yazanus94-dot/Open-Source-Engineering-Simulation-Portfolio/03-cadquery-parametric-flange/README.md

# CadQuery Parametric Flange

**Domain:** CAD / Parametric Design  
**Author:** [Yazan Aljabari](https://www.linkedin.com/in/yazan-aljabari-878202139/)  
**Part of:** [Open-Source Engineering Simulation Portfolio](../README.md)

## Overview
Parametric solid modeling in CadQuery (outer/inner diameters, thickness, PCD, hole count/size) with export utilities and unit tests.

## Problem statement
Generate a parametric bolt-circle pipe flange and export STEP/STL artifacts programmatically.

## Objectives
- Provide a clear, reproducible project setup for the stated engineering/scientific workflow.
- Capture core modeling/simulation/design assumptions in versioned source files.
- Document expected inputs, execution steps, and interpretation boundaries without fabricating results.

## Features
- Source/configuration artifacts included and tracked in this directory: see **Project structure**.
- Domain-appropriate workflow using: CadQuery, Python, pytest.
- Documentation of prerequisites, usage, methodology, and limitations for transparent reuse.

## Technologies
Python, CadQuery, OCP, pytest, STEP/STL

## Project structure
```text
03-cadquery-parametric-flange/
  README.md
  flange.py
  requirements.txt
  tests/test_flange.py
```

## Installation
### Prerequisites
- Install the required external toolchain(s) for this project (e.g., CadQuery, Python, pytest) using official/vendor instructions for your OS.
- A POSIX-like shell is helpful for `.sh` scripts; on Windows, use WSL/Git Bash/MSYS2 or adapt commands as needed.
- For Python-based utilities/tests (if present), Python 3.10+ and `pip` are recommended.

### Setup
1. Open this project directory.
2. Install tool-specific dependencies listed in local files (e.g., `requirements.txt`, `Makefile`, input decks).
3. Ensure required solvers/tools are on `PATH`.

## Usage
Refer to the included scripts/configuration files in this directory and the original project notes below.
- If Python tests are included, run them with `pytest` in an environment where project dependencies are available.

Typical artifacts produced by simulation/design tools (meshes, logs, field outputs, plots, binaries) are generated by running the workflow and may be excluded or regenerated as needed.

## Methodology
- **Inputs/configuration:** Defined by the included source, input, mesh, or netlist files in this folder.
- **Execution:** Run the provided script/command flow with the appropriate solver or EDA/CAD tool.
- **Outputs/analysis:** Post-process generated results with included scripts/tools (e.g., ParaView, plotting utilities, testbenches/check scripts) when applicable.
- **Validation approach:** Compare against analytical/benchmark expectations or built-in checks described in project files where provided; do not claim results that were not produced.

## Results
No fabricated numerical/experimental results are included. This repository contains the **source inputs, scripts, and configuration** required to run the workflow. When executed in a properly configured environment with the required external tools, results (fields, plots, logs, meshes, waveforms, or derived metrics) are produced by those tools. Any example outputs documented in the original project notes are tool-generated and should be reproduced by the user.

## Testing
- If a `tests/` directory or test scripts are present, run them in a compatible environment (some require domain packages such as CadQuery/pymatgen or external tools).
- Where automated tests are not feasible without external solvers, validation is performed by correct configuration, script structure, and reproducible run instructions.

## Limitations
- Requires external domain-specific software that is not bundled in this repository.
- Simplified/educational setups may not capture all real-world physics, manufacturing constraints, or production verification requirements.
- Results depend on tool versions, meshes/time steps/tolerances, and environment configuration.
- No guaranteed solver outputs are committed unless explicitly included as generated artifacts.

## Future improvements
- Add containerized/tool-version-pinned environments for deterministic runs.
- Include verified reference outputs (logs/plots/metrics) generated from documented tool versions.
- Expand automated checks and CI coverage where lightweight validation is possible.
- Add parameter sweeps, convergence studies, or verification/validation benchmarks.

## References
- Tool/vendor documentation for listed technologies (OpenFOAM, Elmer, SU2, CalculiX, Gmsh, FEniCSx, Quantum ESPRESSO, LAMMPS, ngspice, Xyce, Yosys, Verilator, KiCad, CadQuery, OpenSCAD, PyBaMM, ASE, pymatgen) as applicable.
- Project source files included in this directory.

## License
This project is licensed under the **MIT License** (see repository root [`LICENSE`](../LICENSE)).

## Original project notes
# CadQuery - Parametric Pipe Flange with Unit Tests

Code-CAD flange (bolt circle, hub, bore) driven by parameters; exports STEP/STL and computes mass.
A pytest suite verifies the solid volume against the analytical formula - CAD treated as testable software.

```bash
pip install -r requirements.txt
python flange.py --od 160 --bolts 8
pytest -q
```
View `flange.step` in FreeCAD / `cq-editor`; slice `flange.stl` for 3D printing.

## Skills demonstrated
Parametric design, selectors, boolean ops, STEP/STL export, test-driven CAD.
