yazanus94-dot/Open-Source-Engineering-Simulation-Portfolio/11-xyce-bridge-rectifier/README.md

# Xyce Bridge Rectifier

**Domain:** Circuit Simulation / Power Electronics  
**Author:** [Yazan Aljabari](https://www.linkedin.com/in/yazan-aljabari-878202139/)  
**Part of:** [Open-Source Engineering Simulation Portfolio](../README.md)

## Overview
Xyce transient simulation of a full-wave bridge with scripted execution and Python post-processing/analysis.

## Problem statement
Simulate a diode bridge rectifier with RC smoothing and quantify ripple/output characteristics.

## Objectives
- Provide a clear, reproducible project setup for the stated engineering/scientific workflow.
- Capture core modeling/simulation/design assumptions in versioned source files.
- Document expected inputs, execution steps, and interpretation boundaries without fabricating results.

## Features
- Source/configuration artifacts included and tracked in this directory: see **Project structure**.
- Domain-appropriate workflow using: Xyce, Python.
- Documentation of prerequisites, usage, methodology, and limitations for transparent reuse.

## Technologies
Xyce, SPICE, Python, Shell

## Project structure
```text
11-xyce-bridge-rectifier/
  README.md
  analyze.py
  bridge.cir
  run.sh
```

## Installation
### Prerequisites
- Install the required external toolchain(s) for this project (e.g., Xyce, Python) using official/vendor instructions for your OS.
- A POSIX-like shell is helpful for `.sh` scripts; on Windows, use WSL/Git Bash/MSYS2 or adapt commands as needed.
- For Python-based utilities/tests (if present), Python 3.10+ and `pip` are recommended.

### Setup
1. Open this project directory.
2. Install tool-specific dependencies listed in local files (e.g., `requirements.txt`, `Makefile`, input decks).
3. Ensure required solvers/tools are on `PATH`.

## Usage
Run the provided entry script(s) in an environment with the required toolchain installed (see Installation/Prerequisites). Inspect scripts before running.

Typical artifacts produced by simulation/design tools (meshes, logs, field outputs, plots, binaries) are generated by running the workflow and may be excluded or regenerated as needed.

## Methodology
- **Inputs/configuration:** Defined by the included source, input, mesh, or netlist files in this folder.
- **Execution:** Run the provided script/command flow with the appropriate solver or EDA/CAD tool.
- **Outputs/analysis:** Post-process generated results with included scripts/tools (e.g., ParaView, plotting utilities, testbenches/check scripts) when applicable.
- **Validation approach:** Compare against analytical/benchmark expectations or built-in checks described in project files where provided; do not claim results that were not produced.

## Results
No fabricated numerical/experimental results are included. This repository contains the **source inputs, scripts, and configuration** required to run the workflow. When executed in a properly configured environment with the required external tools, results (fields, plots, logs, meshes, waveforms, or derived metrics) are produced by those tools. Any example outputs documented in the original project notes are tool-generated and should be reproduced by the user.

## Testing
- If a `tests/` directory or test scripts are present, run them in a compatible environment (some require domain packages such as CadQuery/pymatgen or external tools).
- Where automated tests are not feasible without external solvers, validation is performed by correct configuration, script structure, and reproducible run instructions.

## Limitations
- Requires external domain-specific software that is not bundled in this repository.
- Simplified/educational setups may not capture all real-world physics, manufacturing constraints, or production verification requirements.
- Results depend on tool versions, meshes/time steps/tolerances, and environment configuration.
- No guaranteed solver outputs are committed unless explicitly included as generated artifacts.

## Future improvements
- Add containerized/tool-version-pinned environments for deterministic runs.
- Include verified reference outputs (logs/plots/metrics) generated from documented tool versions.
- Expand automated checks and CI coverage where lightweight validation is possible.
- Add parameter sweeps, convergence studies, or verification/validation benchmarks.

## References
- Tool/vendor documentation for listed technologies (OpenFOAM, Elmer, SU2, CalculiX, Gmsh, FEniCSx, Quantum ESPRESSO, LAMMPS, ngspice, Xyce, Yosys, Verilator, KiCad, CadQuery, OpenSCAD, PyBaMM, ASE, pymatgen) as applicable.
- Project source files included in this directory.

## License
This project is licensed under the **MIT License** (see repository root [`LICENSE`](../LICENSE)).

## Original project notes
# Xyce - Bridge Rectifier Ripple Study (Parametric `.STEP` Sweep)

Parallel-capable SPICE (Sandia Xyce): 50 Hz full-wave rectifier, diode `.MODEL`, `.PARAM`,
`.STEP` sweep over filter capacitance, CSV output, ripple extraction and comparison with the analytic estimate
dV = I/(2 f C).

```bash
./run.sh
```
Note: Xyce names stepped outputs `bridge.csv`, `bridge.csv.FREQ...` depending on version - `analyze.py` globs them.
Extension: Monte-Carlo (`.SAMPLING`), temperature sweep, transformer + diode reverse-recovery study.

## Skills demonstrated
Xyce netlist syntax (differs from ngspice), `.PARAM/.STEP/.PRINT`, nonlinear device models, results post-processing.
