yazanus94-dot/Open-Source-Engineering-Simulation-Portfolio/13-calculix-cantilever-beam/README.md

# CalculiX Cantilever Beam

**Domain:** FEA / Structural  
**Author:** [Yazan Aljabari](https://www.linkedin.com/in/yazan-aljabari-878202139/)  
**Part of:** [Open-Source Engineering Simulation Portfolio](../README.md)

## Overview
Gmsh-to-CalculiX mesh/input generation, CCX solve, and Python result checking against Euler–Bernoulli deflection.

## Problem statement
Perform 3D linear static analysis of a cantilever beam and compare tip deflection to beam theory.

## Objectives
- Provide a clear, reproducible project setup for the stated engineering/scientific workflow.
- Capture core modeling/simulation/design assumptions in versioned source files.
- Document expected inputs, execution steps, and interpretation boundaries without fabricating results.

## Features
- Source/configuration artifacts included and tracked in this directory: see **Project structure**.
- Domain-appropriate workflow using: CalculiX, Gmsh, Python.
- Documentation of prerequisites, usage, methodology, and limitations for transparent reuse.

## Technologies
CalculiX (ccx), Gmsh, Python, FRD/VTU

## Project structure
```text
13-calculix-cantilever-beam/
  README.md
  check.py
  make_inp.py
  run.sh
```

## Installation
### Prerequisites
- Install the required external toolchain(s) for this project (e.g., CalculiX, Gmsh, Python) using official/vendor instructions for your OS.
- A POSIX-like shell is helpful for `.sh` scripts; on Windows, use WSL/Git Bash/MSYS2 or adapt commands as needed.
- For Python-based utilities/tests (if present), Python 3.10+ and `pip` are recommended.

### Setup
1. Open this project directory.
2. Install tool-specific dependencies listed in local files (e.g., `requirements.txt`, `Makefile`, input decks).
3. Ensure required solvers/tools are on `PATH`.

## Usage
Run the provided entry script(s) in an environment with the required toolchain installed (see Installation/Prerequisites). Inspect scripts before running.

Typical artifacts produced by simulation/design tools (meshes, logs, field outputs, plots, binaries) are generated by running the workflow and may be excluded or regenerated as needed.

## Methodology
- **Inputs/configuration:** Defined by the included source, input, mesh, or netlist files in this folder.
- **Execution:** Run the provided script/command flow with the appropriate solver or EDA/CAD tool.
- **Outputs/analysis:** Post-process generated results with included scripts/tools (e.g., ParaView, plotting utilities, testbenches/check scripts) when applicable.
- **Validation approach:** Compare against analytical/benchmark expectations or built-in checks described in project files where provided; do not claim results that were not produced.

## Results
No fabricated numerical/experimental results are included. This repository contains the **source inputs, scripts, and configuration** required to run the workflow. When executed in a properly configured environment with the required external tools, results (fields, plots, logs, meshes, waveforms, or derived metrics) are produced by those tools. Any example outputs documented in the original project notes are tool-generated and should be reproduced by the user.

## Testing
- If a `tests/` directory or test scripts are present, run them in a compatible environment (some require domain packages such as CadQuery/pymatgen or external tools).
- Where automated tests are not feasible without external solvers, validation is performed by correct configuration, script structure, and reproducible run instructions.

## Limitations
- Requires external domain-specific software that is not bundled in this repository.
- Simplified/educational setups may not capture all real-world physics, manufacturing constraints, or production verification requirements.
- Results depend on tool versions, meshes/time steps/tolerances, and environment configuration.
- No guaranteed solver outputs are committed unless explicitly included as generated artifacts.

## Future improvements
- Add containerized/tool-version-pinned environments for deterministic runs.
- Include verified reference outputs (logs/plots/metrics) generated from documented tool versions.
- Expand automated checks and CI coverage where lightweight validation is possible.
- Add parameter sweeps, convergence studies, or verification/validation benchmarks.

## References
- Tool/vendor documentation for listed technologies (OpenFOAM, Elmer, SU2, CalculiX, Gmsh, FEniCSx, Quantum ESPRESSO, LAMMPS, ngspice, Xyce, Yosys, Verilator, KiCad, CadQuery, OpenSCAD, PyBaMM, ASE, pymatgen) as applicable.
- Project source files included in this directory.

## License
This project is licensed under the **MIT License** (see repository root [`LICENSE`](../LICENSE)).

## Original project notes
# CalculiX - Cantilever Beam Verification

Scripted pre-processing (structured hex mesh + `.inp` generated in Python), static linear solve with `ccx`,
and verification against Euler-Bernoulli and **Timoshenko** (shear-corrected) beam theory.
`C3D8I` (incompatible-mode) elements avoid shear locking that plain `C3D8` shows in bending.

```bash
./run.sh                # change mesh: python make_inp.py 80 8 8
```
Extensions: `C3D20R` elements, modal analysis (`*FREQUENCY`), contact, thermo-mechanical coupling (`*COUPLED TEMPERATURE-DISPLACEMENT`).

## Skills demonstrated
`.inp` keyword structure, element-type selection, BCs & loads, result parsing, verification against analytics.
