yazanus94-dot/Open-Source-Engineering-Simulation-Portfolio/17-verilator-sync-fifo/README.md

# Verilator Synchronous FIFO

**Domain:** Digital Design / Verification  
**Author:** [Yazan Aljabari](https://www.linkedin.com/in/yazan-aljabari-878202139/)  
**Part of:** [Open-Source Engineering Simulation Portfolio](../README.md)

## Overview
Parameterizable FIFO RTL with Verilator-driven cycle simulation, assertions/checks in C++ testbench, and Makefile flow.

## Problem statement
Verify a synchronous FIFO RTL design using a C++ testbench and Verilator simulation.

## Objectives
- Provide a clear, reproducible project setup for the stated engineering/scientific workflow.
- Capture core modeling/simulation/design assumptions in versioned source files.
- Document expected inputs, execution steps, and interpretation boundaries without fabricating results.

## Features
- Source/configuration artifacts included and tracked in this directory: see **Project structure**.
- Domain-appropriate workflow using: Verilator, C++, Verilog.
- Documentation of prerequisites, usage, methodology, and limitations for transparent reuse.

## Technologies
Verilog, Verilator, C++, Make

## Project structure
```text
17-verilator-sync-fifo/
  Makefile
  README.md
  fifo.v
  tb.cpp
```

## Installation
### Prerequisites
- Install the required external toolchain(s) for this project (e.g., Verilator, C++, Verilog) using official/vendor instructions for your OS.
- A POSIX-like shell is helpful for `.sh` scripts; on Windows, use WSL/Git Bash/MSYS2 or adapt commands as needed.
- For Python-based utilities/tests (if present), Python 3.10+ and `pip` are recommended.

### Setup
1. Open this project directory.
2. Install tool-specific dependencies listed in local files (e.g., `requirements.txt`, `Makefile`, input decks).
3. Ensure required solvers/tools are on `PATH`.

## Usage
Run the provided entry script(s) in an environment with the required toolchain installed (see Installation/Prerequisites). Inspect scripts before running.

Typical artifacts produced by simulation/design tools (meshes, logs, field outputs, plots, binaries) are generated by running the workflow and may be excluded or regenerated as needed.

## Methodology
- **Inputs/configuration:** Defined by the included source, input, mesh, or netlist files in this folder.
- **Execution:** Run the provided script/command flow with the appropriate solver or EDA/CAD tool.
- **Outputs/analysis:** Post-process generated results with included scripts/tools (e.g., ParaView, plotting utilities, testbenches/check scripts) when applicable.
- **Validation approach:** Compare against analytical/benchmark expectations or built-in checks described in project files where provided; do not claim results that were not produced.

## Results
No fabricated numerical/experimental results are included. This repository contains the **source inputs, scripts, and configuration** required to run the workflow. When executed in a properly configured environment with the required external tools, results (fields, plots, logs, meshes, waveforms, or derived metrics) are produced by those tools. Any example outputs documented in the original project notes are tool-generated and should be reproduced by the user.

## Testing
- If a `tests/` directory or test scripts are present, run them in a compatible environment (some require domain packages such as CadQuery/pymatgen or external tools).
- Where automated tests are not feasible without external solvers, validation is performed by correct configuration, script structure, and reproducible run instructions.

## Limitations
- Requires external domain-specific software that is not bundled in this repository.
- Simplified/educational setups may not capture all real-world physics, manufacturing constraints, or production verification requirements.
- Results depend on tool versions, meshes/time steps/tolerances, and environment configuration.
- No guaranteed solver outputs are committed unless explicitly included as generated artifacts.

## Future improvements
- Add containerized/tool-version-pinned environments for deterministic runs.
- Include verified reference outputs (logs/plots/metrics) generated from documented tool versions.
- Expand automated checks and CI coverage where lightweight validation is possible.
- Add parameter sweeps, convergence studies, or verification/validation benchmarks.

## References
- Tool/vendor documentation for listed technologies (OpenFOAM, Elmer, SU2, CalculiX, Gmsh, FEniCSx, Quantum ESPRESSO, LAMMPS, ngspice, Xyce, Yosys, Verilator, KiCad, CadQuery, OpenSCAD, PyBaMM, ASE, pymatgen) as applicable.
- Project source files included in this directory.

## License
This project is licensed under the **MIT License** (see repository root [`LICENSE`](../LICENSE)).

## Original project notes
# Verilator - Synchronous FIFO with C++ Reference-Model Testbench

RTL FIFO (parameterised, Gray-free pointer-wrap full/empty) verified by a **C++ testbench** driven by Verilator:
bursty random traffic (forces full and empty conditions), a `std::queue` scoreboard, flag checking, and VCD tracing.
Verilator compiles the RTL to C++ so 200k cycles run in well under a second.

```bash
make lint   # Verilator -Wall lint
make run    # build, simulate, print PASS/FAIL
gtkwave fifo.vcd
```
Extensions: SystemVerilog assertions (`--assert`), coverage (`--coverage` + `verilator_coverage`), async FIFO with Gray-coded pointers, cocotb integration.

## Skills demonstrated
Verilator flow (lint, C++ harness, tracing), RTL design, scoreboarding, directed-random verification.
