yazanus94-dot/Open-Source-Engineering-Simulation-Portfolio/06-su2-naca0012-transonic/naca0012.cfg

% Inviscid transonic flow, NACA0012, M=0.8, AoA=1.25 deg
SOLVER= EULER
MATH_PROBLEM= DIRECT
MACH_NUMBER= 0.8
AOA= 1.25
FREESTREAM_PRESSURE= 101325.0
FREESTREAM_TEMPERATURE= 288.15
REF_ORIGIN_MOMENT_X= 0.25
REF_LENGTH= 1.0
REF_AREA= 1.0
MARKER_EULER= ( airfoil )
MARKER_FAR= ( farfield )
MARKER_PLOTTING= ( airfoil )
MARKER_MONITORING= ( airfoil )
NUM_METHOD_GRAD= WEIGHTED_LEAST_SQUARES
CFL_NUMBER= 10.0
CFL_ADAPT= YES
CFL_ADAPT_PARAM= ( 0.5, 1.2, 1.0, 100.0 )
CONV_NUM_METHOD_FLOW= JST
JST_SENSOR_COEFF= ( 0.5, 0.02 )
TIME_DISCRE_FLOW= EULER_IMPLICIT
LINEAR_SOLVER= FGMRES
LINEAR_SOLVER_PREC= ILU
LINEAR_SOLVER_ERROR= 1E-6
LINEAR_SOLVER_ITER= 10
ITER= 1500
CONV_RESIDUAL_MINVAL= -10
CONV_STARTITER= 10
MESH_FILENAME= naca0012.su2
MESH_FORMAT= SU2
TABULAR_FORMAT= CSV
CONV_FILENAME= history
SOLUTION_FILENAME= solution_flow
OUTPUT_FILES= (RESTART, PARAVIEW, SURFACE_CSV)
SCREEN_OUTPUT= (INNER_ITER, RMS_DENSITY, LIFT, DRAG)
