yazanus94-dot/Open-Source-Engineering-Simulation-Portfolio/(commit log)

2026-11-11 Restructure portfolio: extract 18 projects, add comprehensive docs/READMEs, validation CI, results dashboard, landing page, and MIT license
    [bom.csv, enclosure.scad, naca0012.cfg]
2026-11-11 Remove 02-elmer-plate-heat-conduction.zip after extraction
2026-11-11 Remove 05-openscad-parametric-enclosure.zip after extraction
2026-11-11 Remove 09-pybamm-battery-simulation.zip after extraction
2026-11-11 Remove 10-ngspice-analog-filters.zip after extraction
2026-11-11 Remove 16-gmsh-adaptive-plate-with-hole.zip after extraction
2026-11-11 Remove 18-kicad-555-astable-blinker.zip after extraction
